arun0413/my-major-project/minor report/copy.pdf

# SENTRY GUN - Autonomous Turret

# Project members

### RA1811018010133(rk8115@srmist.edu.in)

### Project Guide:Dr. S. Fouziya Sulthana

Faculty Incharge - Dr. Madhavan Shanmugavel

MINOR PROJECT –MECHATRONICS, ODD SEM 2021, REVIEW 2

# Project

## - Problem statement:

- during border protection many lives of a country’s soldiers are lost so to prevent that
- a sentry gun is needed to be developed to keep the terrorists and intruders away from the countries borders

## - List of Objectives :

For a sentry gun, the following things are needed to be made:
1.A physical frame that can holster a airsoft gun needs to be designed and constructed(STRUCTURE1)
2. (A structure 2) which can rotate and manage the whole (STRUCTURE 1)
3. A base which can support the (STRUCTURE 2)
3. a distribution board for servo
4. Electronics to control the speed of the gun to shoot perfectly

As the software part is outsourced
I chose a software with following features:
Manual Control
Autonomus mode
Git link : https://github.com/sentryGun53/Project-Sentry-Gun

MINOR PROJECT –MECHATRONICS, ODD SEM 2021, REVIEW 2

# List of solutions

## - List of possible solutions The

airsoft gun directly mounted inbetween the two supports with two bolts
- Servos ae directly connected without gear mechanism
- unique mount for the gun is made and mounted inbetween the two supports with bolts
- Here servos are connected to a spur gear to reduce the inertia
- Using a swivel bearing bearing instead of castor wheels
- Making separate power distribution board for servos

## - List of criteria for evaluating the solutions Cost

- Easy assembly and disassembly
- Easy maintenance
- Less inertia when the gun comes to a quick stop
- Reduucing the load stress on Arduino and servo

MINOR PROJECT –MECHATRONICS, ODD SEM 2021, REVIEW 2

# Selected solution

## - Criteria based on the solution is selected

- “unique mount for the gun is made and mounted in between the two supports with rods
- Here servos are connected to a spur gear to reduce the inertia”
- This solution was chosen as its easy to remove the gun from the mount and using the spur gears between the rods and the servos greatly reduce the inertia

## - Tools used and analysis done on

- I tested the following by directly making a model :
- Using a futaba servo with plastic gears “plastic gears not able to withstand the inertia so they broke ”

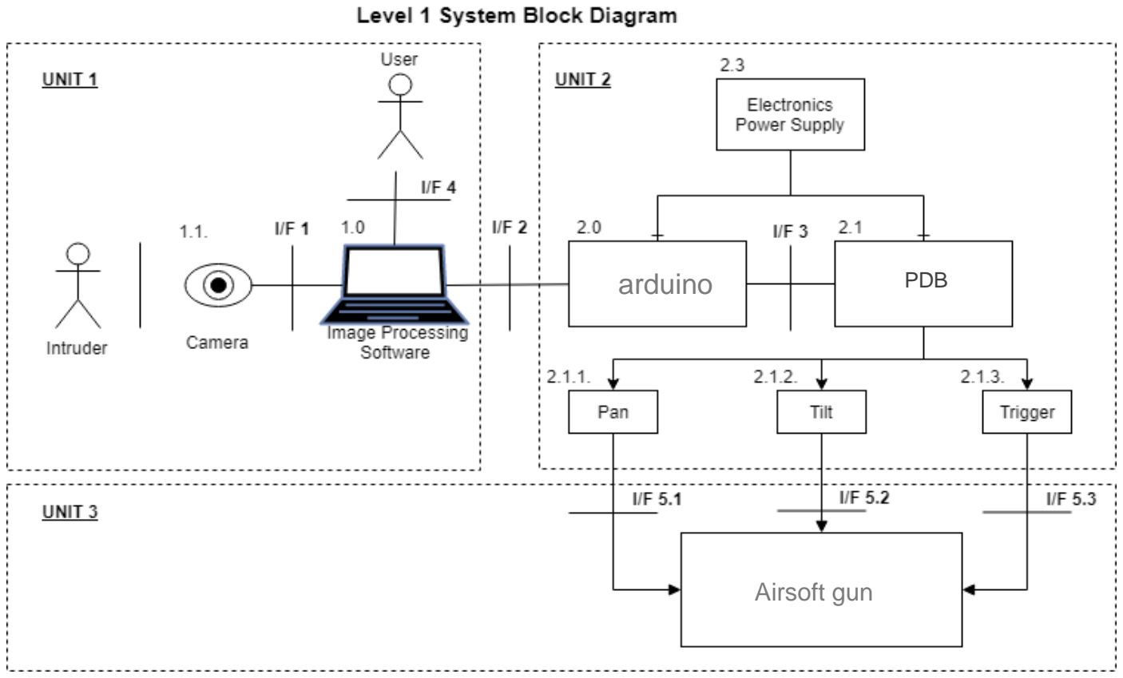
[picture p1: page 5]

Airsoft gun

arduino | PDB

## smps

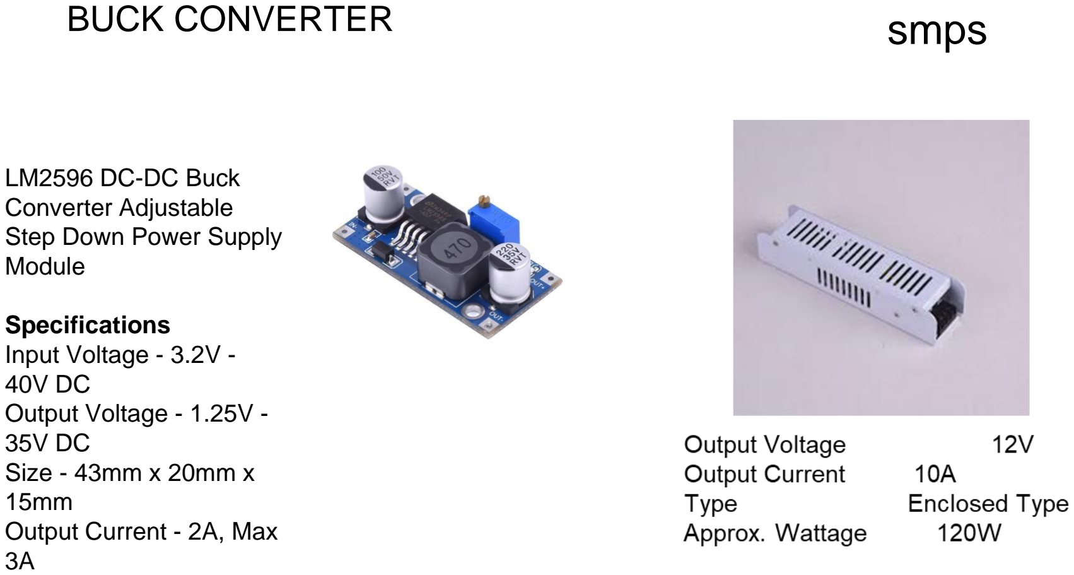
[picture p2: page 6]

### BUCK CONVERTER

LM2596 DC

-DC Buck
Converter Adjustable
Step Down Power Supply
Module

Specifications
Input Voltage
- 3.2V
40V DC
Output Voltage
- 1.25V
35V DC
Size
- 43mm x 20mm x
15mm
Output Current
- 2A, Max
3A

# ARDUINO UNO R3

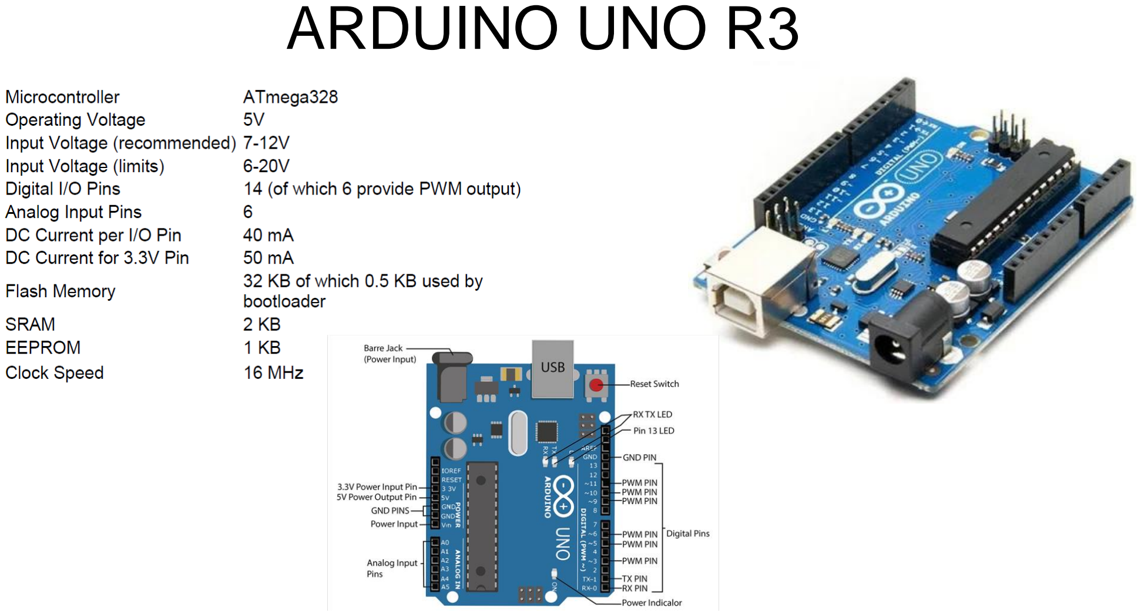
[picture p3: page 7]

# ACTUATORS

MG995 High Speed Servo Actuator

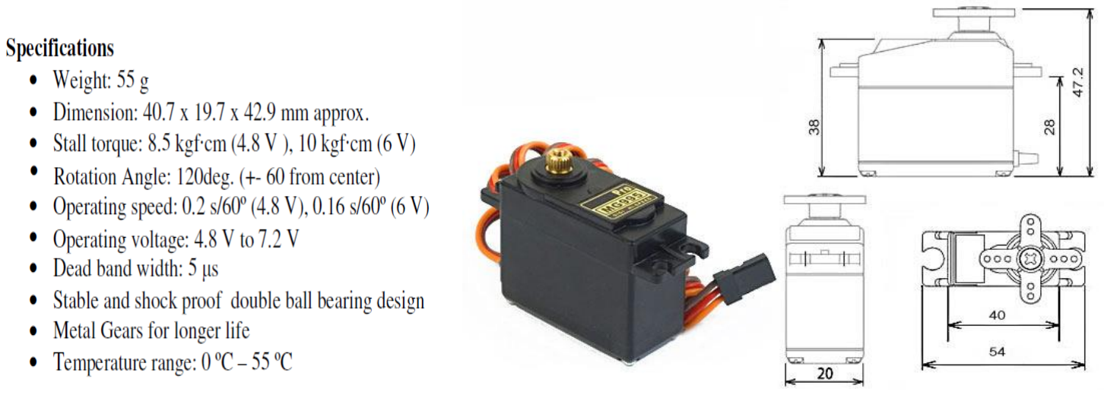
[picture p4: figure]

## Castor wheel

## Spur gear

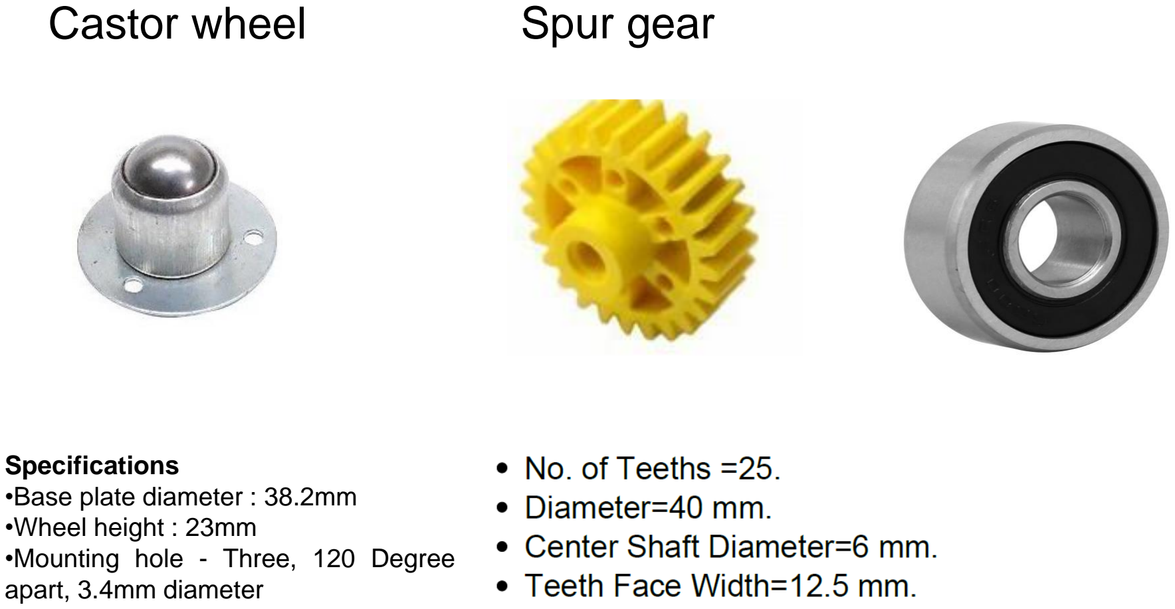
[picture p5: page 9]

Specifications
•Base plate diameter : 38.2mm
•Wheel height : 23mm
•Mounting hole - Three, 120 Degree apart, 3.4mm diameter

# Custom power supply unit for fast deployment

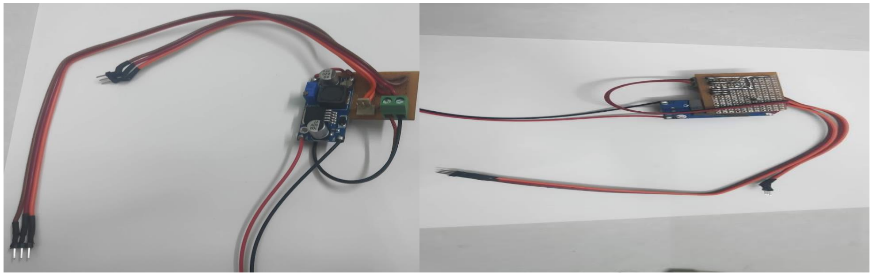
[picture p6: figure]

Bottom view Top view of the board

# Project status

- Work breakdown structure | • Work responsibility matrix

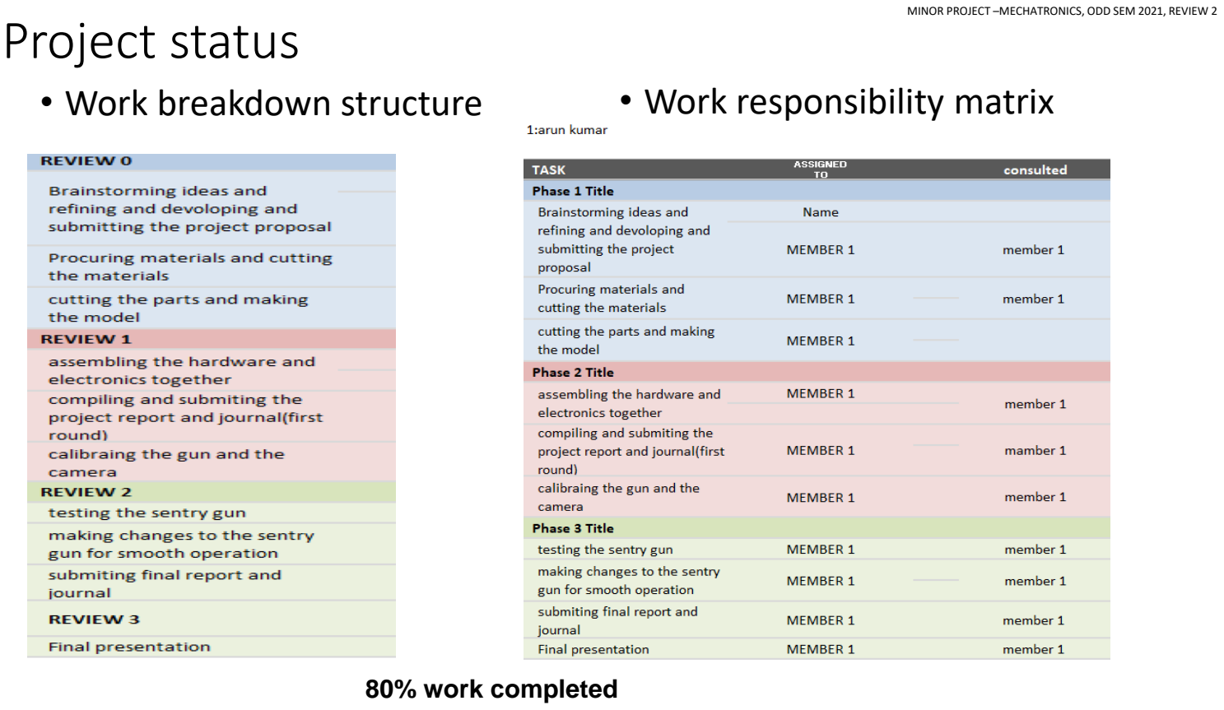
[picture p7: page 11]

MINOR PROJECT –MECHATRONICS, ODD SEM 2021, REVIEW 2

80% work completed

## Gantt chart

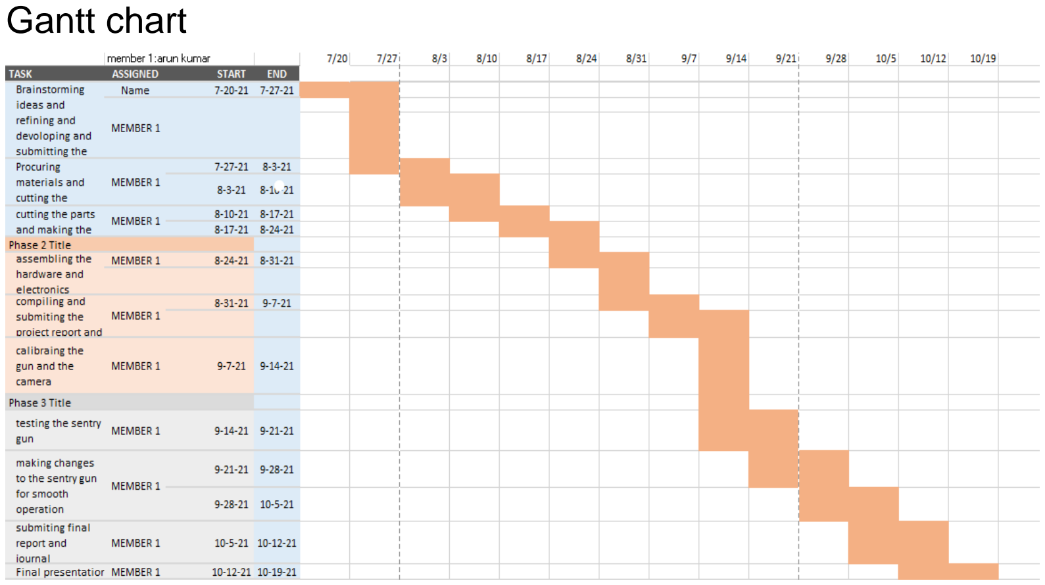
[picture p8: page 12]
