arun0413/my-major-project/3d files/Screenshot 2022-04-29 180808.png

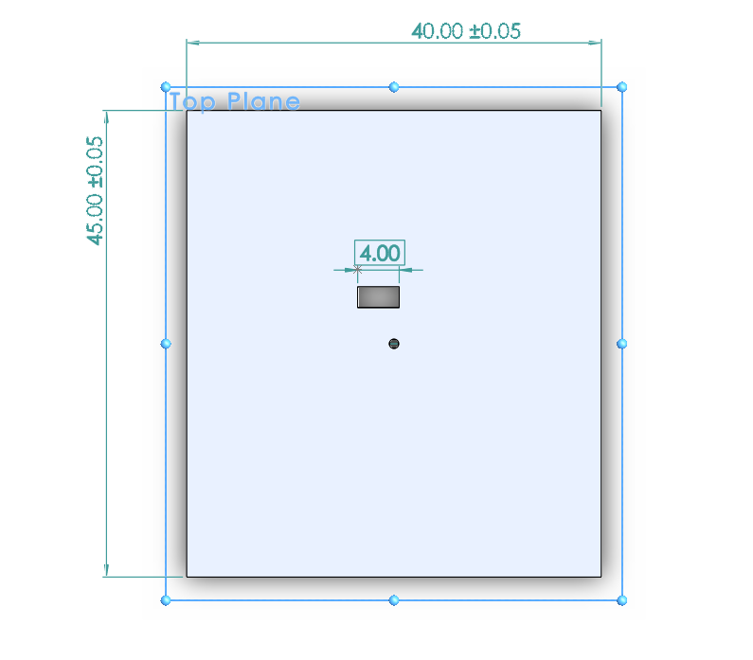
3d files/Screenshot 2022-04-29 180808.png
