arun0413/my-major-project/cad files/cad images/1.PNG

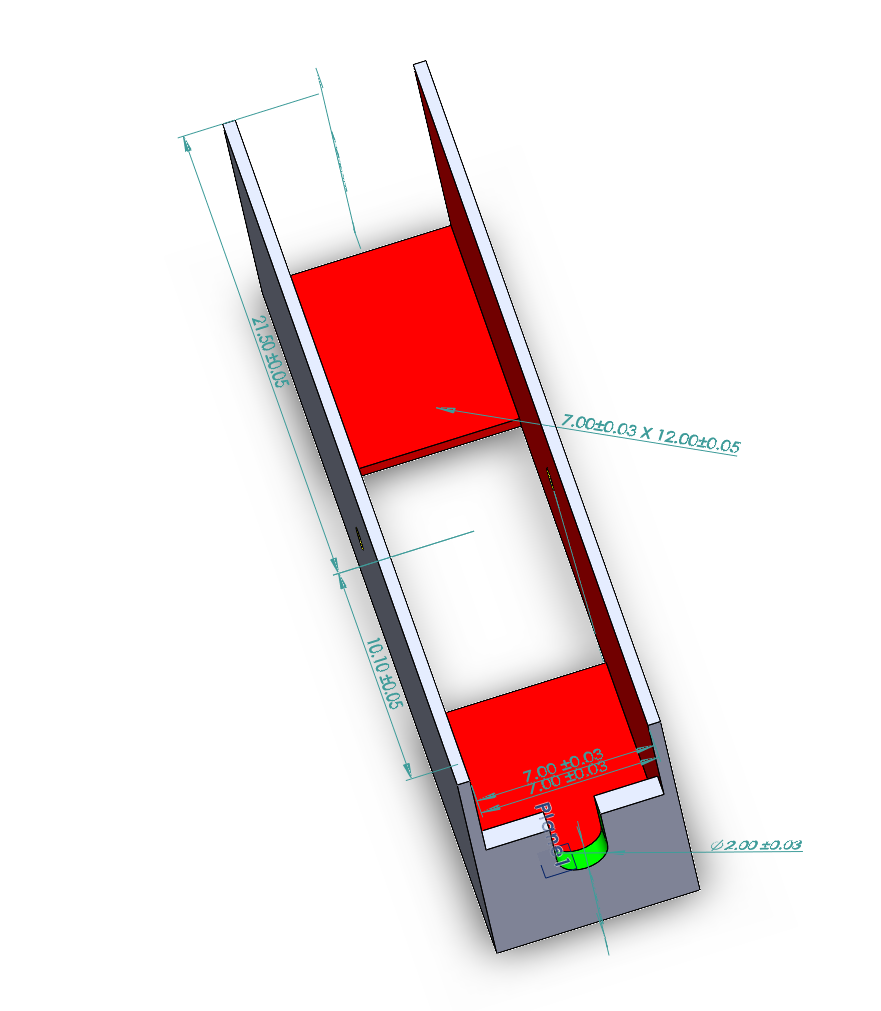
cad files/cad images/1.PNG
