arun0413/my-major-project/cad files/cad images/2.PNG

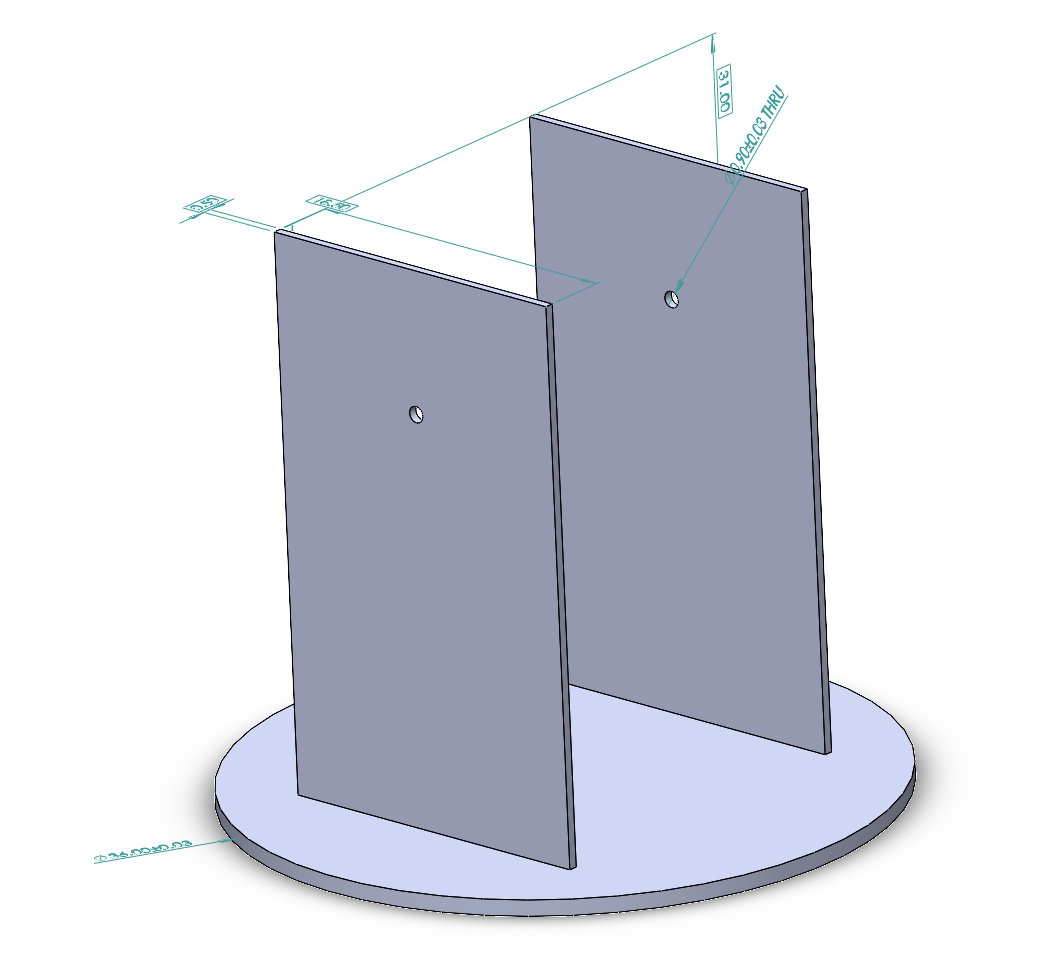
cad files/cad images/2.PNG
