arun0413/my-major-project/cad files/cad images/3.PNG

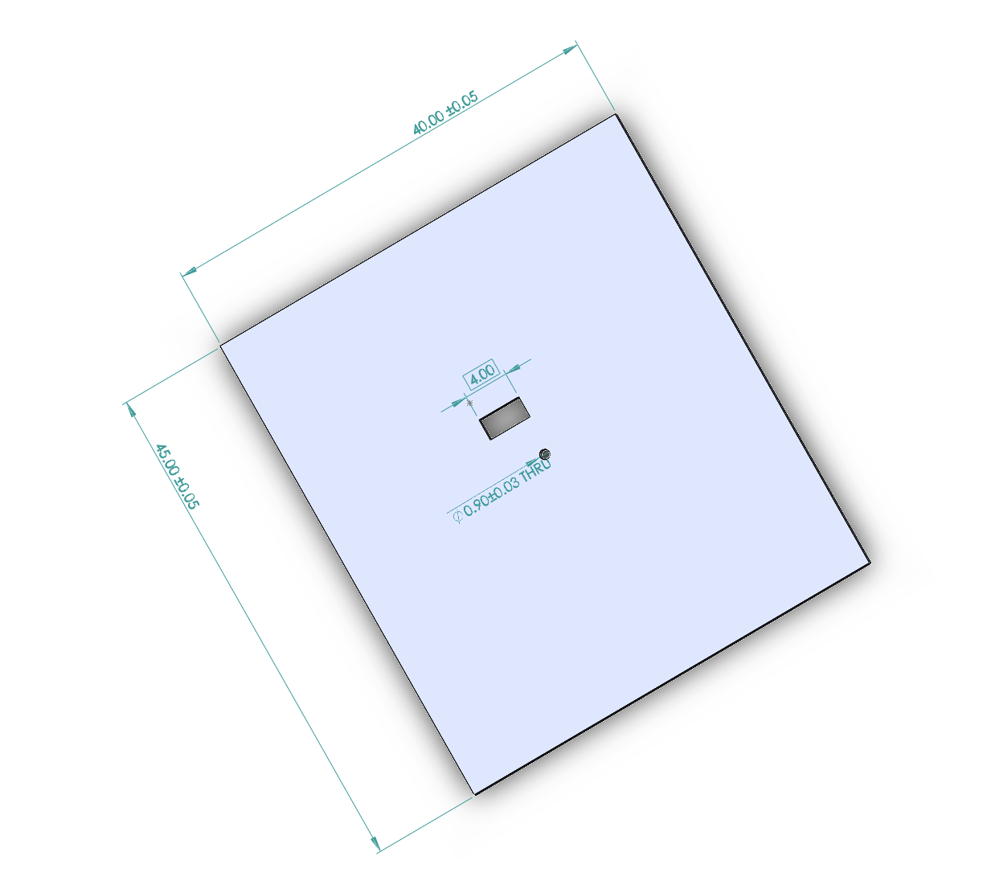
cad files/cad images/3.PNG
