arun0413/my-major-project/cad files/cad images/4.PNG

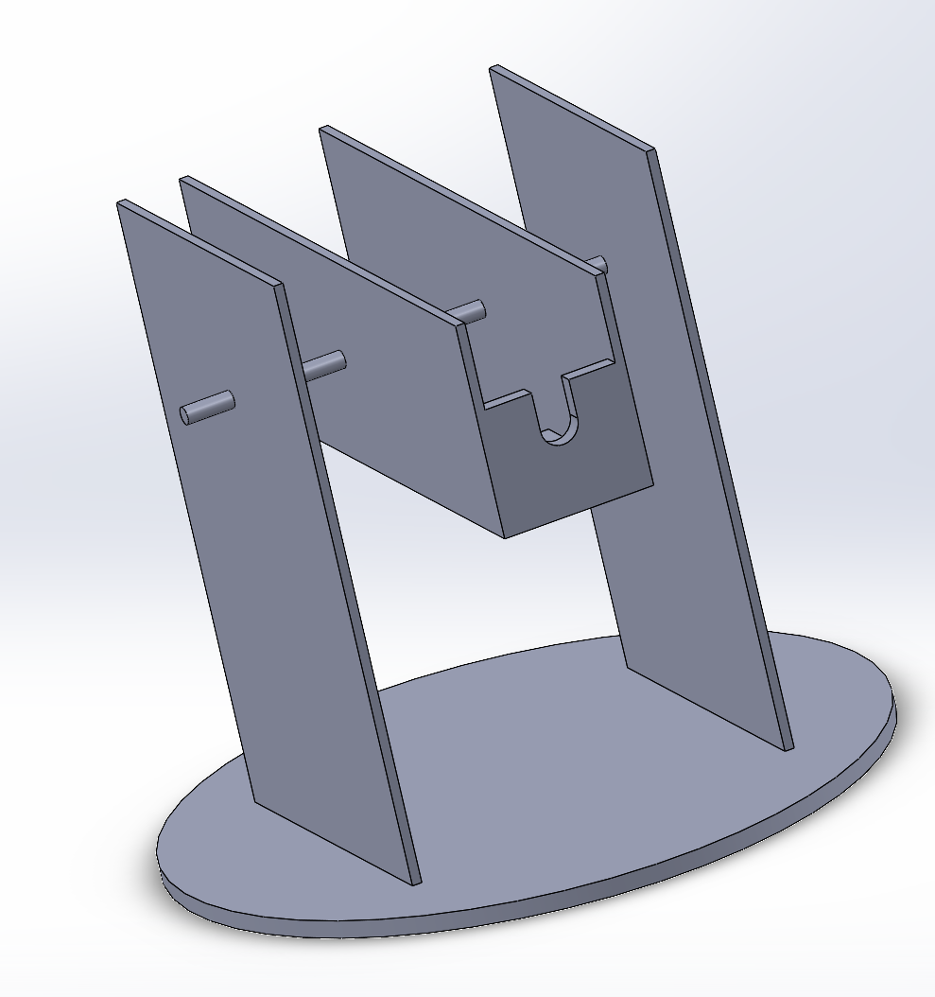
cad files/cad images/4.PNG
