arun0413/my-major-project/cad files/cad images/5.PNG

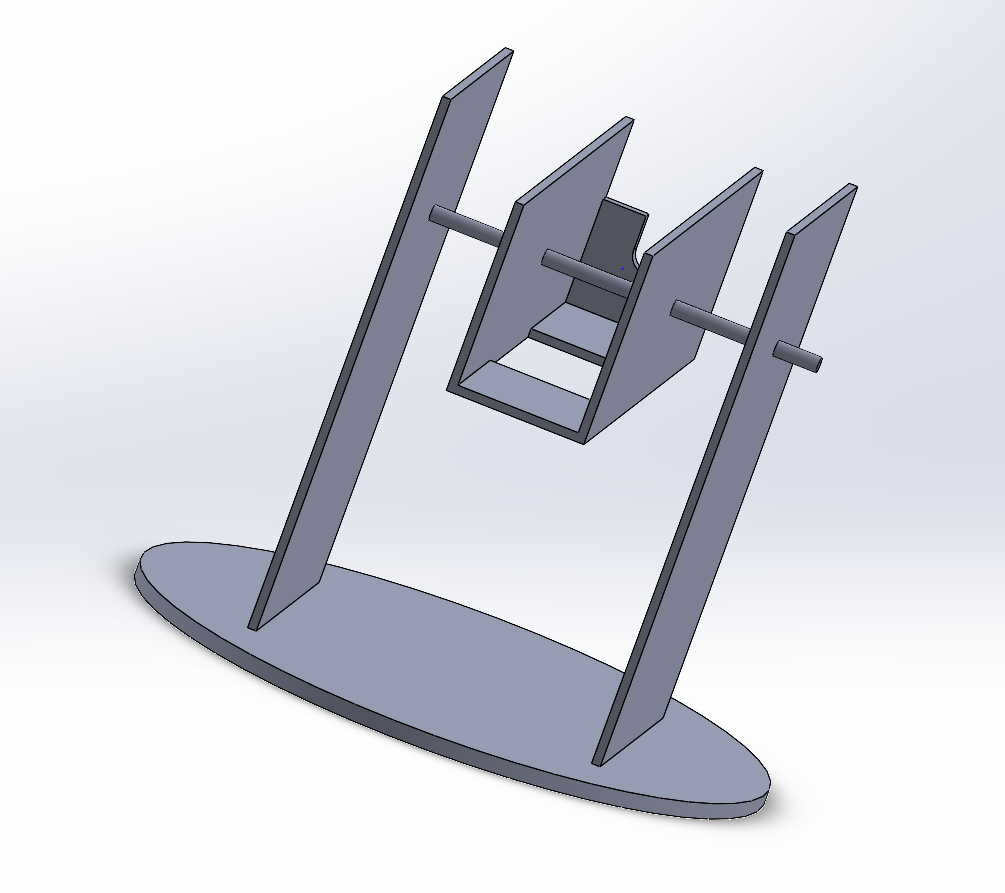
cad files/cad images/5.PNG
