arun0413/my-major-project/cad files/cad images/Capture.PNG

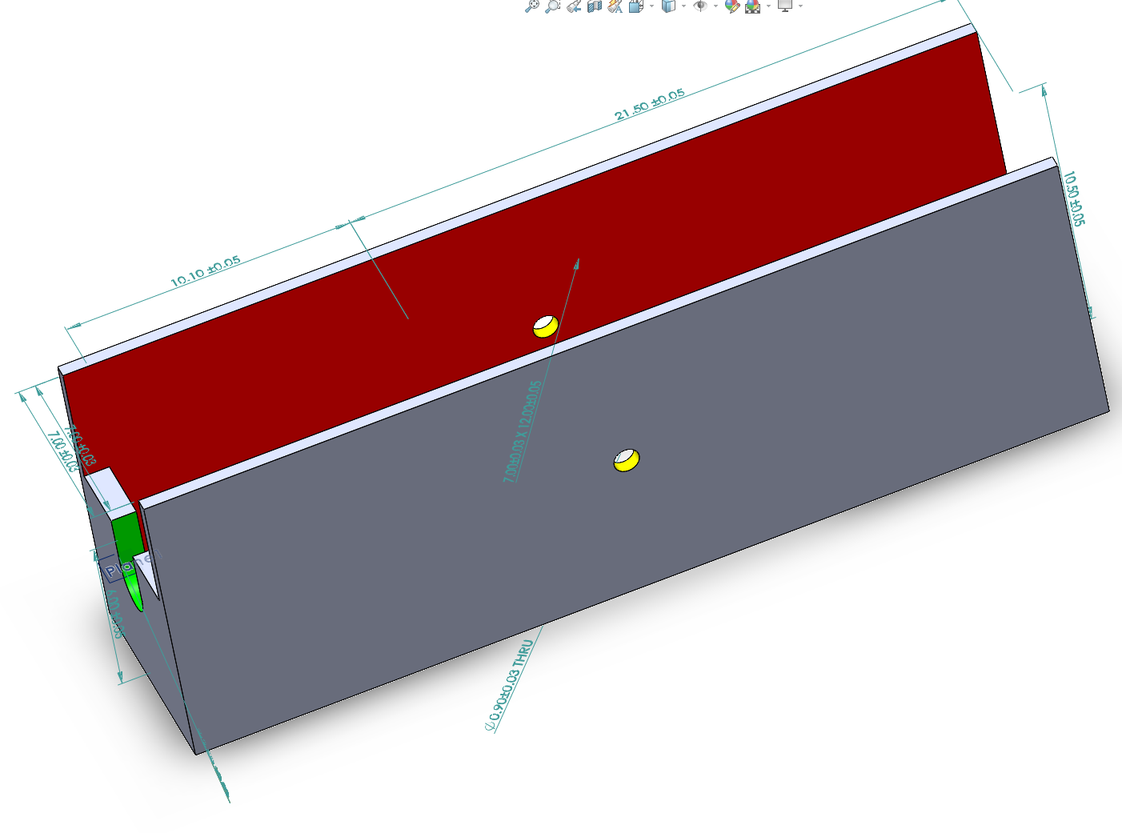
cad files/cad images/Capture.PNG
