arun0413/my-major-project/3d files/Assem1.SLDASM

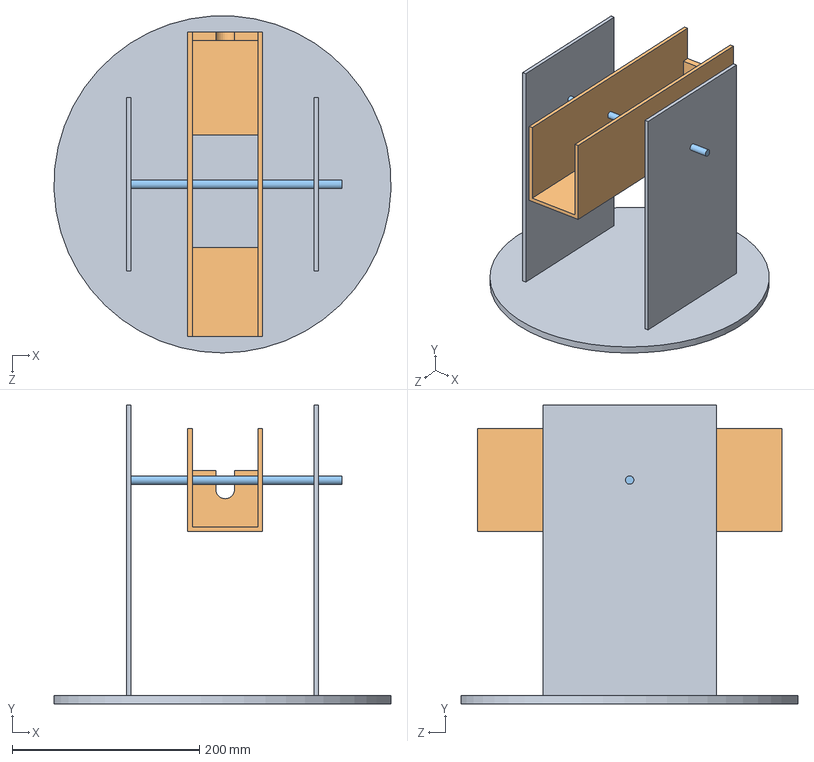
[picture p59: CAD file, 2024-05-09]
3d files/Assem1.SLDASM
359.8 x 319.0 x 359.6 mm
rod
