arun0413/my-major-project/3d files/rower.SLDPRT

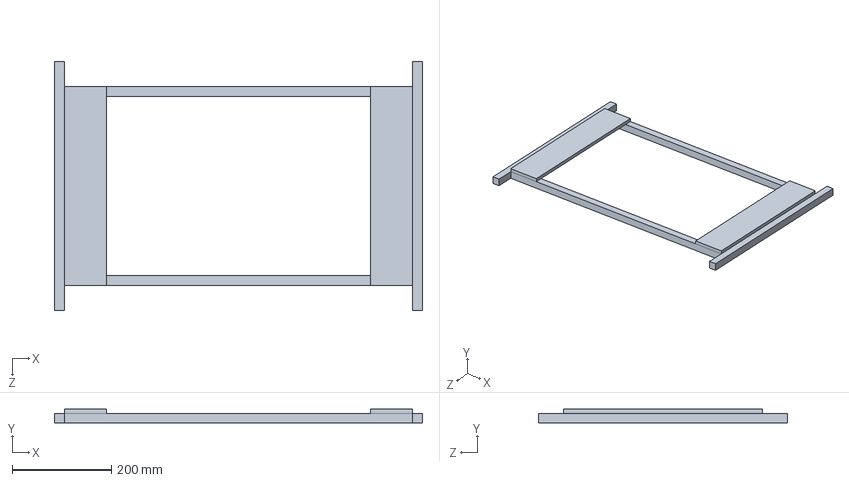
[picture p60: CAD file, 2024-05-09]
3d files/rower.SLDPRT
740.0 x 29.0 x 500.0 mm
