arun0413/my-major-project/3d files/Part3.SLDPRT

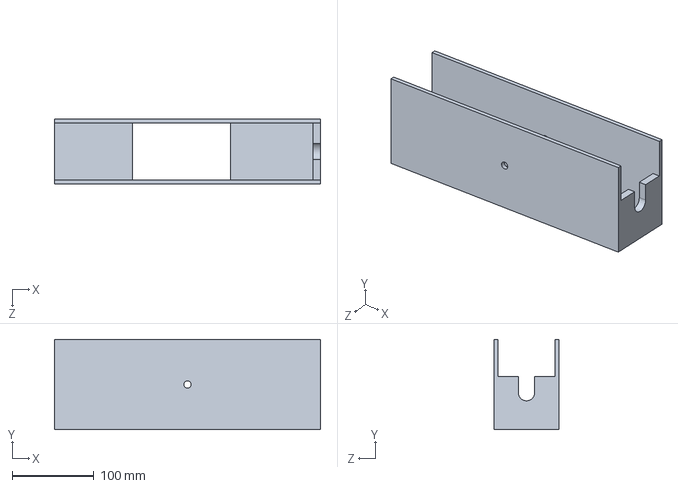
[picture p61: CAD file, 2024-05-09]
3d files/Part3.SLDPRT
325.0 x 110.0 x 80.0 mm
