arun0413/my-major-project/3d files/PART 2.SLDPRT

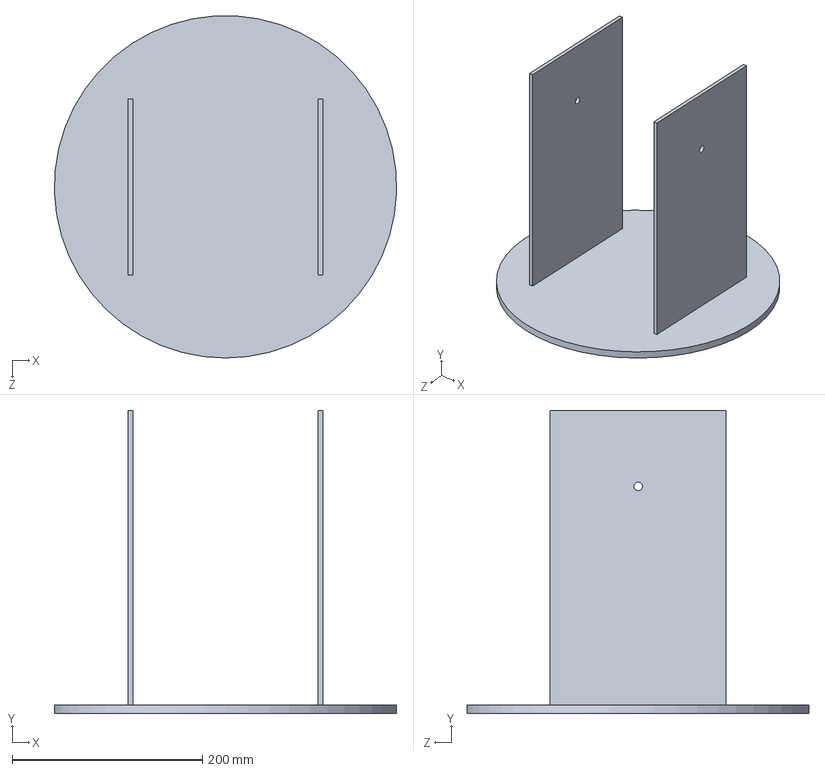
[picture p62: CAD file, 2024-05-09]
3d files/PART 2.SLDPRT
359.8 x 319.0 x 359.6 mm
