arun0413/my-major-project/3d files/rod.SLDPRT

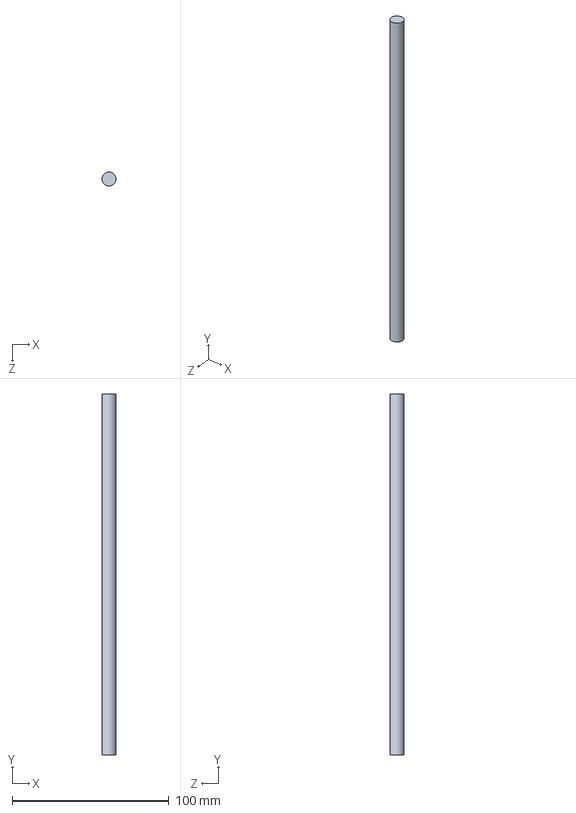
[picture p63: CAD file, 2024-05-09]
3d files/rod.SLDPRT
9.00 x 230.0 x 9.00 mm
