arun0413/my-major-project/3d files/Part1.SLDPRT

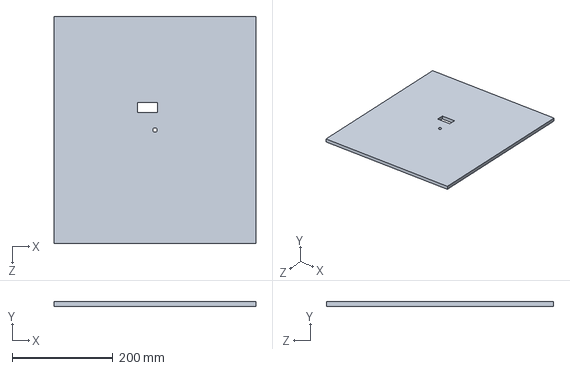
[picture p64: CAD file, 2024-05-09]
3d files/Part1.SLDPRT
400.0 x 9.00 x 450.0 mm
