arun0413/my-major-project/(list of files, cad)

Other CAD files:
3d files/Part1.SLDDRW
