arun0413/my-major-project/codes/radar code NodeMCU_2__1st_proto_4.ino

// Bridge Widget Device B using Blynk App By Solarduino 

// Note Summary
// Note :  Safety is very important when dealing with electricity. We take no responsibilities while you do it at your own risk.
// Note :  This Code wants to read values from Device A. This code uploaded to Device B (This device) in order to collect readings from Device A (other device).
// Note :  The values collected from Device A can be use for further calculation or analysis.
// Note :  You need to create 2 Projects (with 2 Auth tokens from Blynk). Make sure to clearly identify which Auth Token is for which Device.
// Note :  You need to download the Blynk App on your smart phone for display.
// Note :  Solarduino only amend necessary code and integrate with Blynk Server.
// Note :  Blog page for this code : 

/*/////////////////////////////////////////////////////////////////////////////////////////////////////////////////////////////////////////////////////////////////////////////////////*/////////////*/

        
        /* 0- Blynk Server and Wifi Connection */


#define BLYNK_PRINT Serial

/* Fill-in your Template ID (only if using Blynk.Cloud) */
//#define BLYNK_TEMPLATE_ID   "TMPLTkysnM32"


#include <ESP8266WiFi.h>
#include <BlynkSimpleEsp8266.h>

// You should get Auth Token in the Blynk App.
// Go to the Project Settings (nut icon).
char auth[] = "fViXRaLL7-8n9H_Ui1NgBgLRzt4ZhXf0";

// Your WiFi credentials.
// Set password to "" for open networks.
char ssid[] = "mesh_2.4ghz";
char pass[] = "thunderclap";                           // Key in your wifi password.
        BlynkTimer timer;                                     // Create variable for timer function in Blynk App.
        
        /* 0.1 - Bridge Widget Blynk Server */
        
        WidgetBridge bridge1(V10);                            // Assign virtual pin 10 of this device (Device A) for Bridge Widget to communicate with other Devices (Device B) and the channel is named "bridge1"
                                                              // Do not need to do Widget setting. It just let the Blynk server knows that you assign the pin for Bridge Widget. 
        
        /* 1- Values on Device B */

        int degre=0;                                        // create variable for potRead values received from Device A
        int distance=0;                                      // create variable for countTime values received from Device A
                                               // create variable for potRead x countTime values
        unsigned long startMillisReadData;                    // start counting time for value display
        int secondsDataDisplay = 1000;                        // use to calculate time for sensor. By default every 1000 milli seconds.

void setup() 
{
       
        /*0 General*/

        Serial.begin(9600);                                   /* To assign communication with Serial Monitor*/
        Blynk.begin(auth, ssid, pass);                        /* Connecting to Blynk server */
        while (Blynk.connect() == false) {}                   // Wait until Blynk is connected
        //timer.setInterval(1000L, readValue);                  // Every 1000 milli seconds (1 second), run the Void readValue set of function 
                                            
        /* 2 - Data submission to Blynk Server  */

        //startMillisReadData = millis();                       /* Start counting time for data submission to Blynk Server*/
}

void loop() 
{
        /* 0- General */
        
        Blynk.run();                                                /* keep the Blynk active */
        //timer.run(); 
        
        
        /* 1 - Internal calculation in Device B  */
        
        //if(millis() - startMillisReadData >= secondsDataDisplay)    /* every second, run the code*/
        delay(400);//1100 for blank  400 for active
        {
        //Serial.print("degre : ");

        
       Serial.print(degre);
       Serial.print(","); 

        
        /* Read the potentiometer in analog values (0-1024)*/
        //Serial.print("distance : ");
        
       Serial.print(distance);                                  
       Serial.print(".");
        //delay(200);    
     
        //startMillisReadData = millis(); 
        }    
}

BLYNK_WRITE(V5)                                                     // Read the potentiometer values from Blynk Server
{
degre = param.asInt();
//Serial.print(degre);
}

BLYNK_WRITE(V6)                                                     // Read the countTime values from Blynk Server
{
distance = param.asInt();
//Serial.print(distance);
}
